Dolland/Dollander/Board New.png

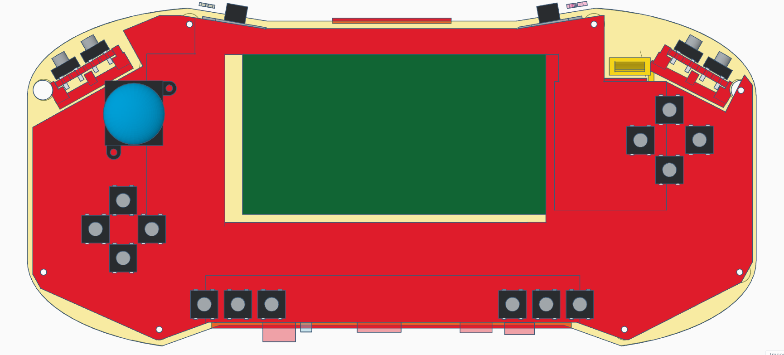
Board New.png
