Dolland/Dollander/board.png

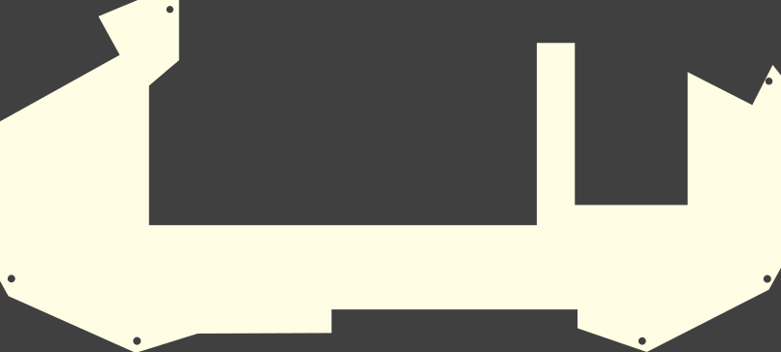
board.png
