Dolland/Dollander/pi-audio-raspi3-audio-schematic-rethemed.jpg

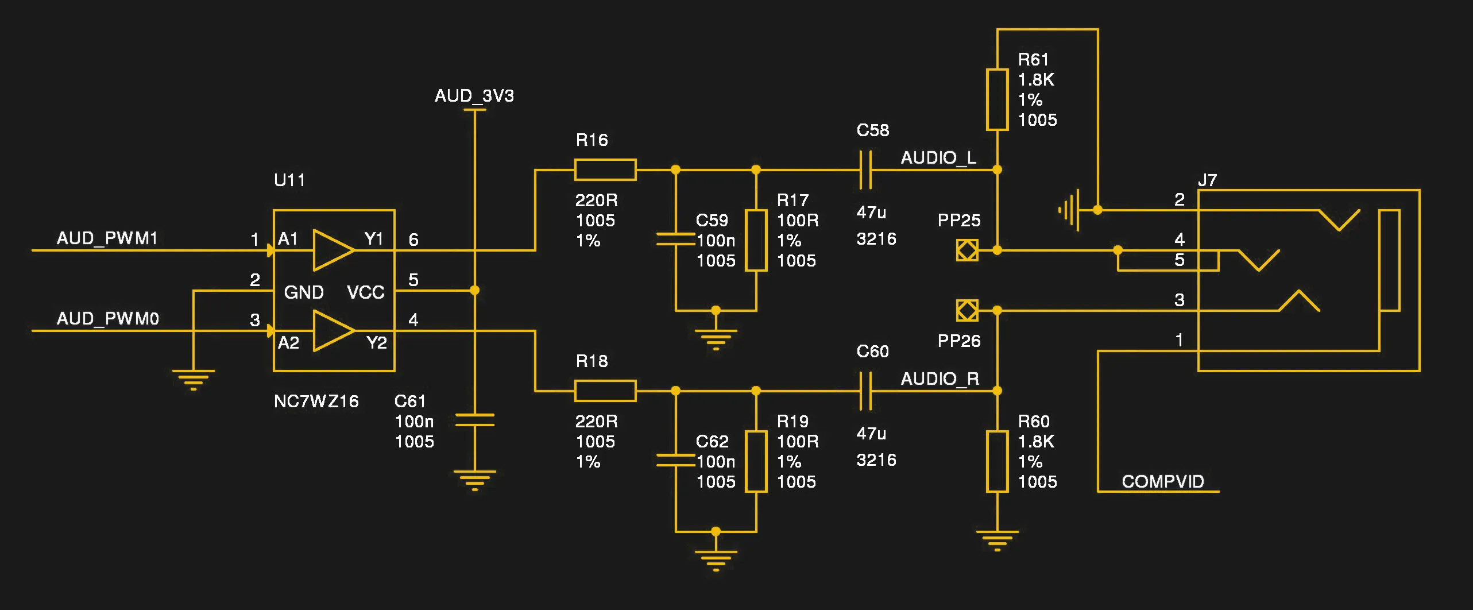
pi-audio-raspi3-audio-schematic-rethemed.jpg
