Dolland/Dollander/raspberry_pi_audiofilter.webp

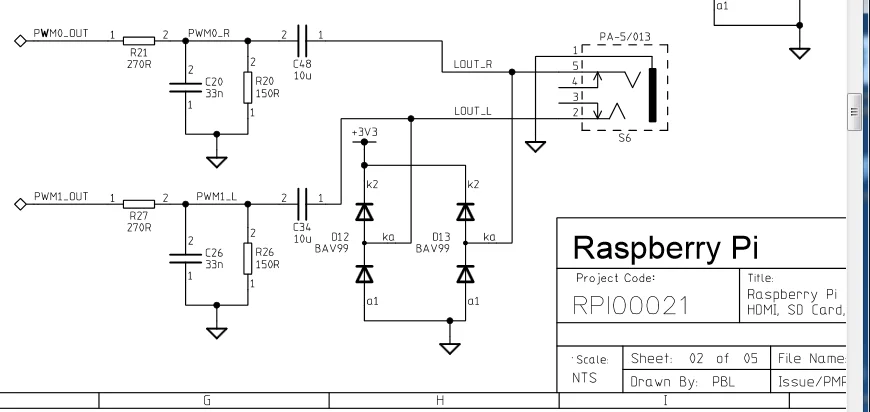
raspberry_pi_audiofilter.webp
