Dolland/Dollander/5inch-hdmi-lcd-sku10563_asm.stp

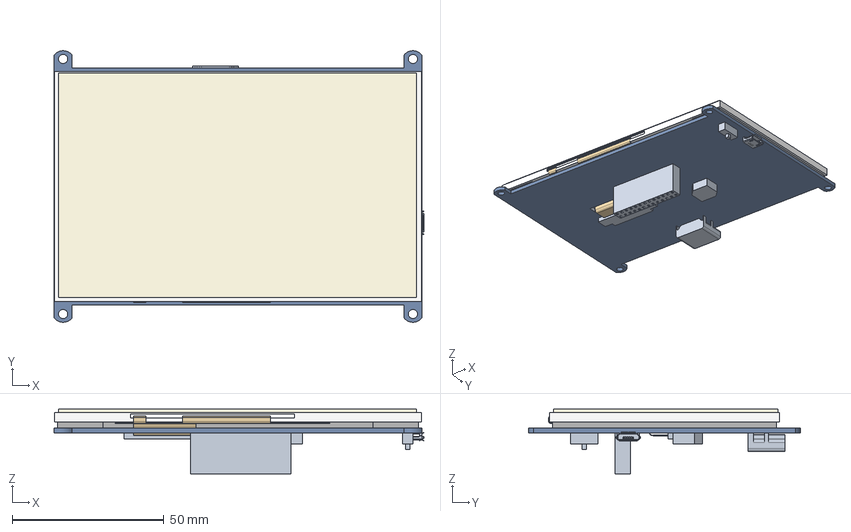
[picture p5: CAD file, 2024-05-19]
5inch-hdmi-lcd-sku10563_asm.stp
121.8 x 89.4 x 21.3 mm
5INCH-LCD-800X480
5INCH-EVA
5INCH-HDMI-LCD-PCB
5INCH-TP
