Dolland/Dollander/Board Console 2023.step

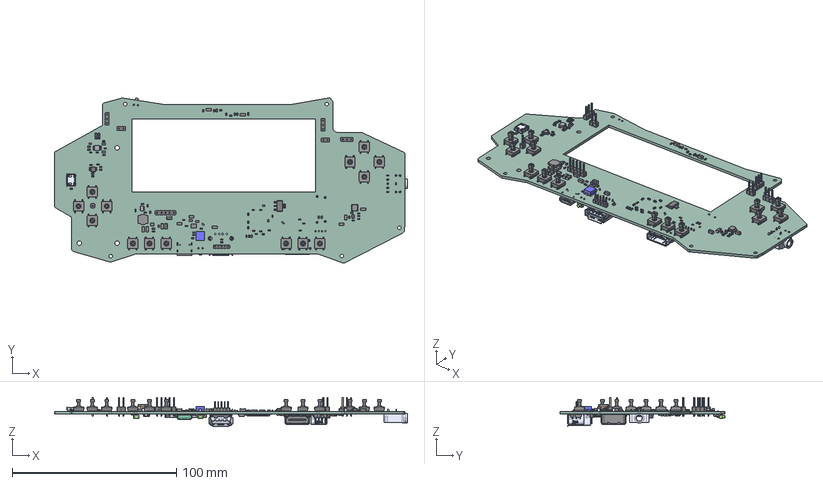
[picture p6: CAD file, 2024-05-20]
Board Console 2023.step
214.9 x 100.6 x 17.9 mm
L_Bourns-SRN4018
R_0603_1608Metric x 45
C_0603_1608Metric x 48
SW_SPST_Omron_B3FS-105xP x 14
PinHeader_1x02_P254mm_Vertical x 2
PinHeader_1x03_P254mm_Vertical x 3
L_1206_3216Metric x 4
PinHeader_1x05_P200mm_Vertical
TC33X-2-202E x 2
C_1206_3216Metric x 10
C_0805_2012Metric x 4
L_0805_2012Metric x 8
PinHeader_1x01_P254mm_Vertical
MP2720AGRH
PinHeader_1x05_P254mm_Vertical
L_Bourns_SRN6045TA
10118194-0001LF
TSSOP_10_3x3mm_P05mm
ASSEMBLY
SOT_223 x 3
D_SOD_123 x 2
R_Array_Convex_4x0603 x 7
RUA42
C-4-1734839-0
LED_D1.8mm_W1.8mm_H2.4mm_Horizontal_O1.27mm_Z1.6mm x 2
10029449-111RLF x 2
CUI_DEVICES_SJ1-3525N
TSOT_23
PZP100
PinHeader_1x04_P200mm_Vertical
M-UE27-AC54-100-REVT1
_X2_4E006B21_X0_MOLDING_-261340
Fillet003_fd_sp
EVQ-P7A01P
Board Console 2023_PCB
