Dolland/Dollander/board.stl

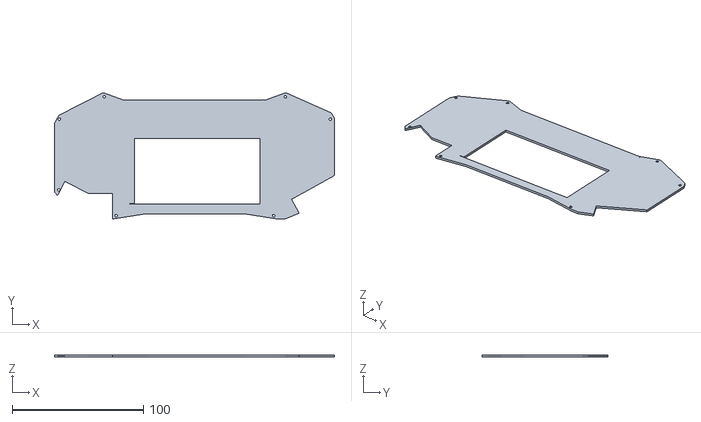
[picture p7: CAD file, 2024-05-19]
board.stl
213.3 x 96.0 x 1.60
