Dolland/Dollander/Board Console 2023.kicad_pcb

## KiCad design Board Console 2023.kicad_pcb (2024-07-20)

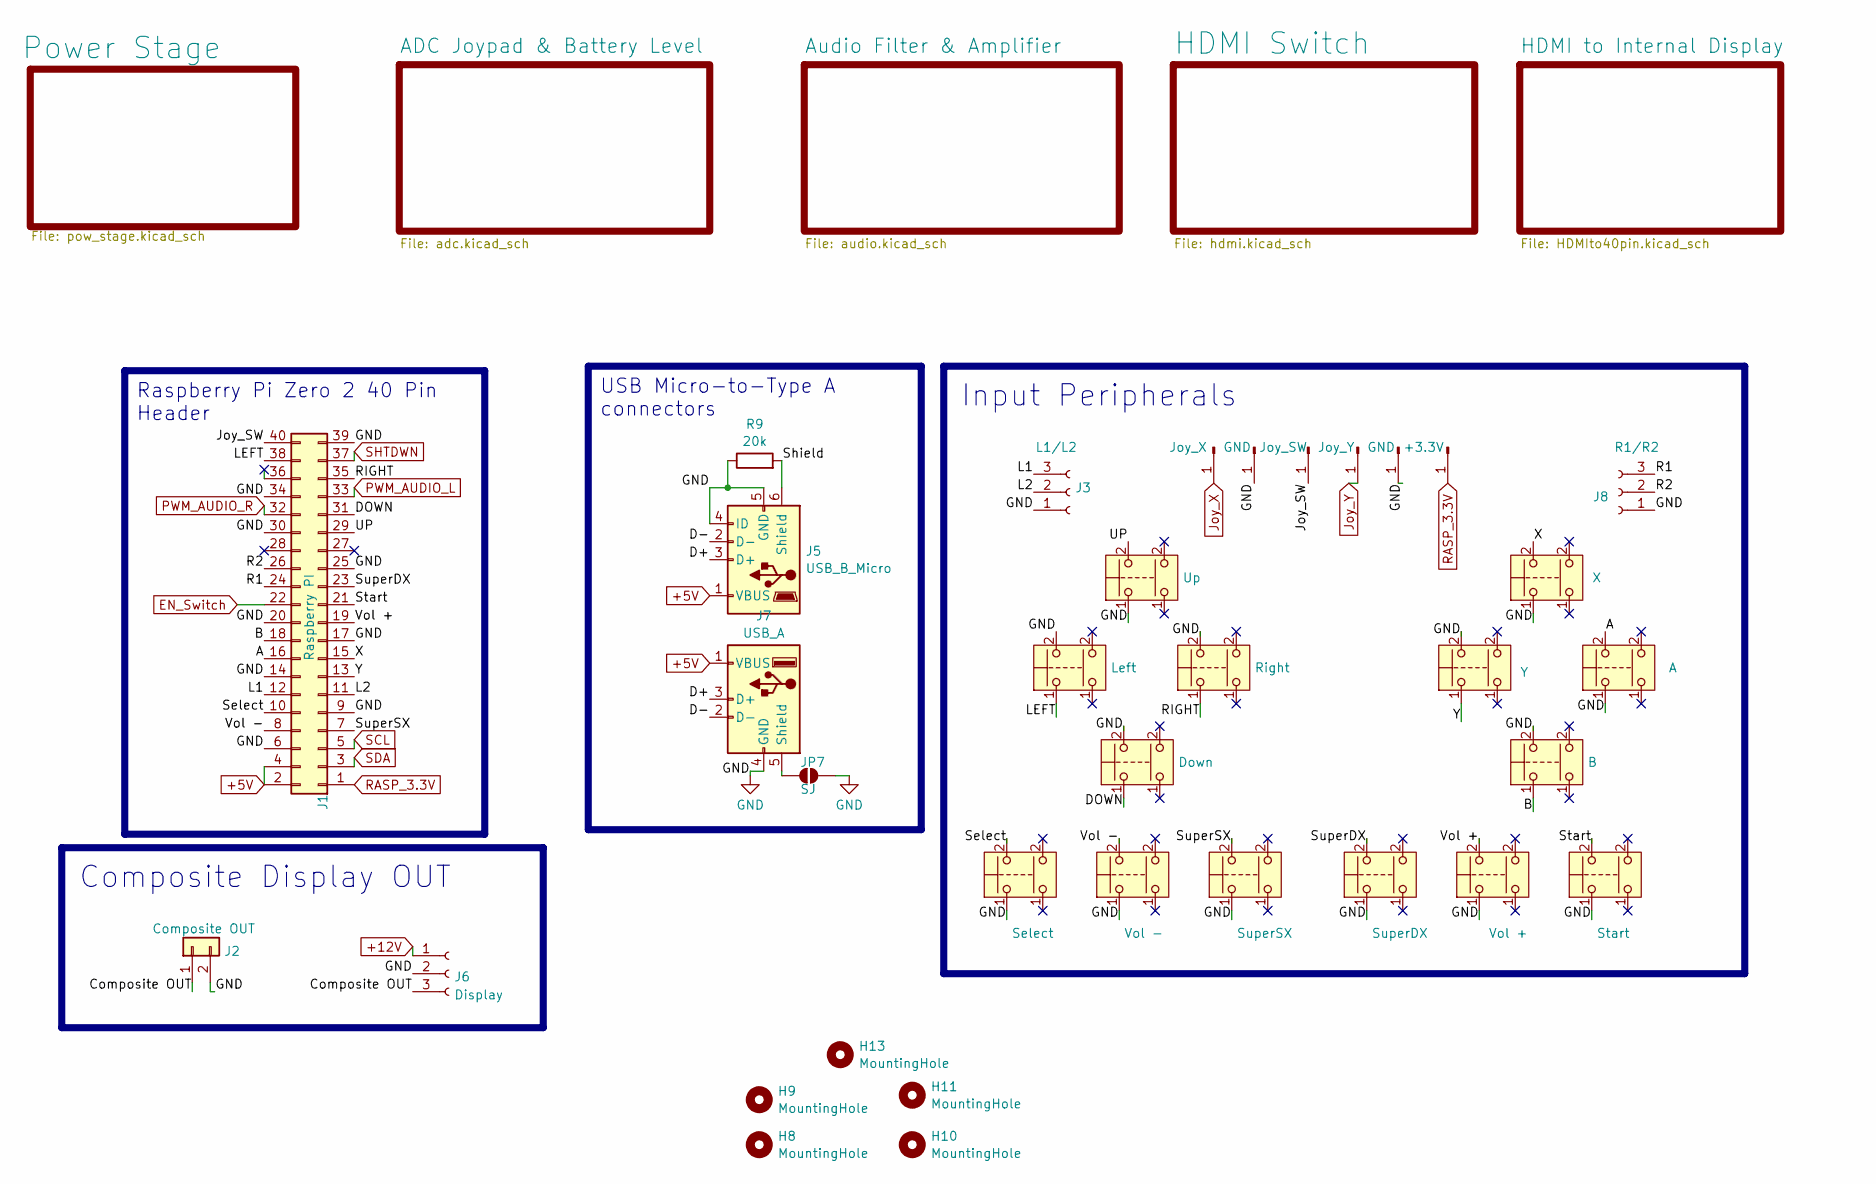
[picture p8: schematic Board Console 2023.kicad_sch, Console]

Parts:
H1: Joy_X; TestPoint_Pad_0.8x2.8
H2, H5: GND; TestPoint_Pad_0.8x2.8
H3: Joy_SW; TestPoint_Pad_0.8x2.8
H4: Joy_Y; TestPoint_Pad_0.8x2.8
H6: +3.3V; TestPoint_Pad_0.8x2.8
H8, H9, H10, H11, H13: MountingHole; MountingHole_2.2mm_M2
J1: Raspberry PI; Raspberry_Pi_Zero_Socketed_THT_FaceUp_MountingHoles
J2: Composite OUT; PinHeader_1x02_P2.00mm_Vertical
J3: L1/L2; PinHeader_1x03_P2.54mm_Vertical
J5: USB_B_Micro; USB_Micro-B_Amphenol_10118194_Horizontal
J6: Display; PinHeader_1x03_P2.54mm_Vertical
J7: USB_A; AMPHENOL_UE27AC5410H
J8: R1/R2; PinHeader_1x03_P2.54mm_Vertical
JP7: SJ; SolderJumper-2_P1.3mm_Open_Pad1.0x1.5mm
R9: 20k; R_0603_1608Metric_Pad0.98x0.95mm_HandSolder
SW3: Vol -; SW_Push_1P1T_NO_6x6mm_H9.5mm
SW4: SuperSX; SW_Push_1P1T_NO_6x6mm_H9.5mm
SW5: Select; SW_Push_1P1T_NO_6x6mm_H9.5mm
SW6: Vol +; SW_Push_1P1T_NO_6x6mm_H9.5mm
SW7: Start; SW_Push_1P1T_NO_6x6mm_H9.5mm
SW8: B; SW_Push_1P1T_NO_6x6mm_H9.5mm
SW9: Y; SW_Push_1P1T_NO_6x6mm_H9.5mm
SW10: A; SW_Push_1P1T_NO_6x6mm_H9.5mm
SW11: X; SW_Push_1P1T_NO_6x6mm_H9.5mm
SW12: Down; SW_Push_1P1T_NO_6x6mm_H9.5mm
SW13: Left; SW_Push_1P1T_NO_6x6mm_H9.5mm
SW14: Up; SW_Push_1P1T_NO_6x6mm_H9.5mm
SW15: Right; SW_Push_1P1T_NO_6x6mm_H9.5mm
SW17: SuperDX; SW_Push_1P1T_NO_6x6mm_H9.5mm

Connections:
+5V: J1.2, J1.4, J5.1 (VBUS), J7.1 (VBUS); also elsewhere on the board
+12V: J6.1; also elsewhere on the board
/A: J1.16, SW10.2
/B: J1.18, SW8.1
/Composite OUT: J2.1, J6.3
/D+: J5.3 (D+), J7.3 (D+)
/D-: J5.2 (D-), J7.2 (D-)
/DOWN: J1.31, SW12.1
/Joy_SW: H3.1, J1.40
/L1: J1.12, J3.3
/L2: J1.11, J3.2
/LEFT: J1.38, SW13.1
/R1: J1.24, J8.3
/R2: J1.26, J8.2
/RIGHT: J1.35, SW15.1
/Select: J1.10, SW5.2
/Shield: J5.6 (Shield), R9.2
/Start: J1.21, SW7.2
/SuperDX: J1.23, SW17.2
/SuperSX: J1.7, SW4.2
/UP: J1.29, SW14.2
/Vol +: J1.19, SW6.2
/Vol -: J1.8, SW3.2
/X: J1.15, SW11.2
/Y: J1.13, SW9.1
EN_Switch: J1.22; also elsewhere on the board
GND: H2.1, H5.1, J1.6, J1.9, J1.14, J1.17, J1.20, J1.25, J1.30, J1.34, J1.39, J2.2, J3.1, J5.4 (ID), J5.5 (GND), J6.2, J7.4 (GND), J8.1, JP7.1 (A), R9.1, SW3.1, SW4.1, SW5.1, SW6.1, SW7.1, SW8.2, SW9.2, SW10.1, SW11.1, SW12.2, SW13.2, SW14.1, SW15.2, SW17.1; also elsewhere on the board
Joy_X: H1.1; also elsewhere on the board
Joy_Y: H4.1; also elsewhere on the board
unnamed: J7.5 (Shield), JP7.2 (B)
PWM_AUDIO_L: J1.33; also elsewhere on the board
PWM_AUDIO_R: J1.32; also elsewhere on the board
RASP_3.3V: H6.1, J1.1; also elsewhere on the board
SCL: J1.5; also elsewhere on the board
SDA: J1.3; also elsewhere on the board
SHTDWN: J1.37; also elsewhere on the board

Notes on the sheet:
Composite Display OUT
Raspberry Pi Zero 2 40 Pin Header
USB Micro-to-Type A connectors
Input Peripherals

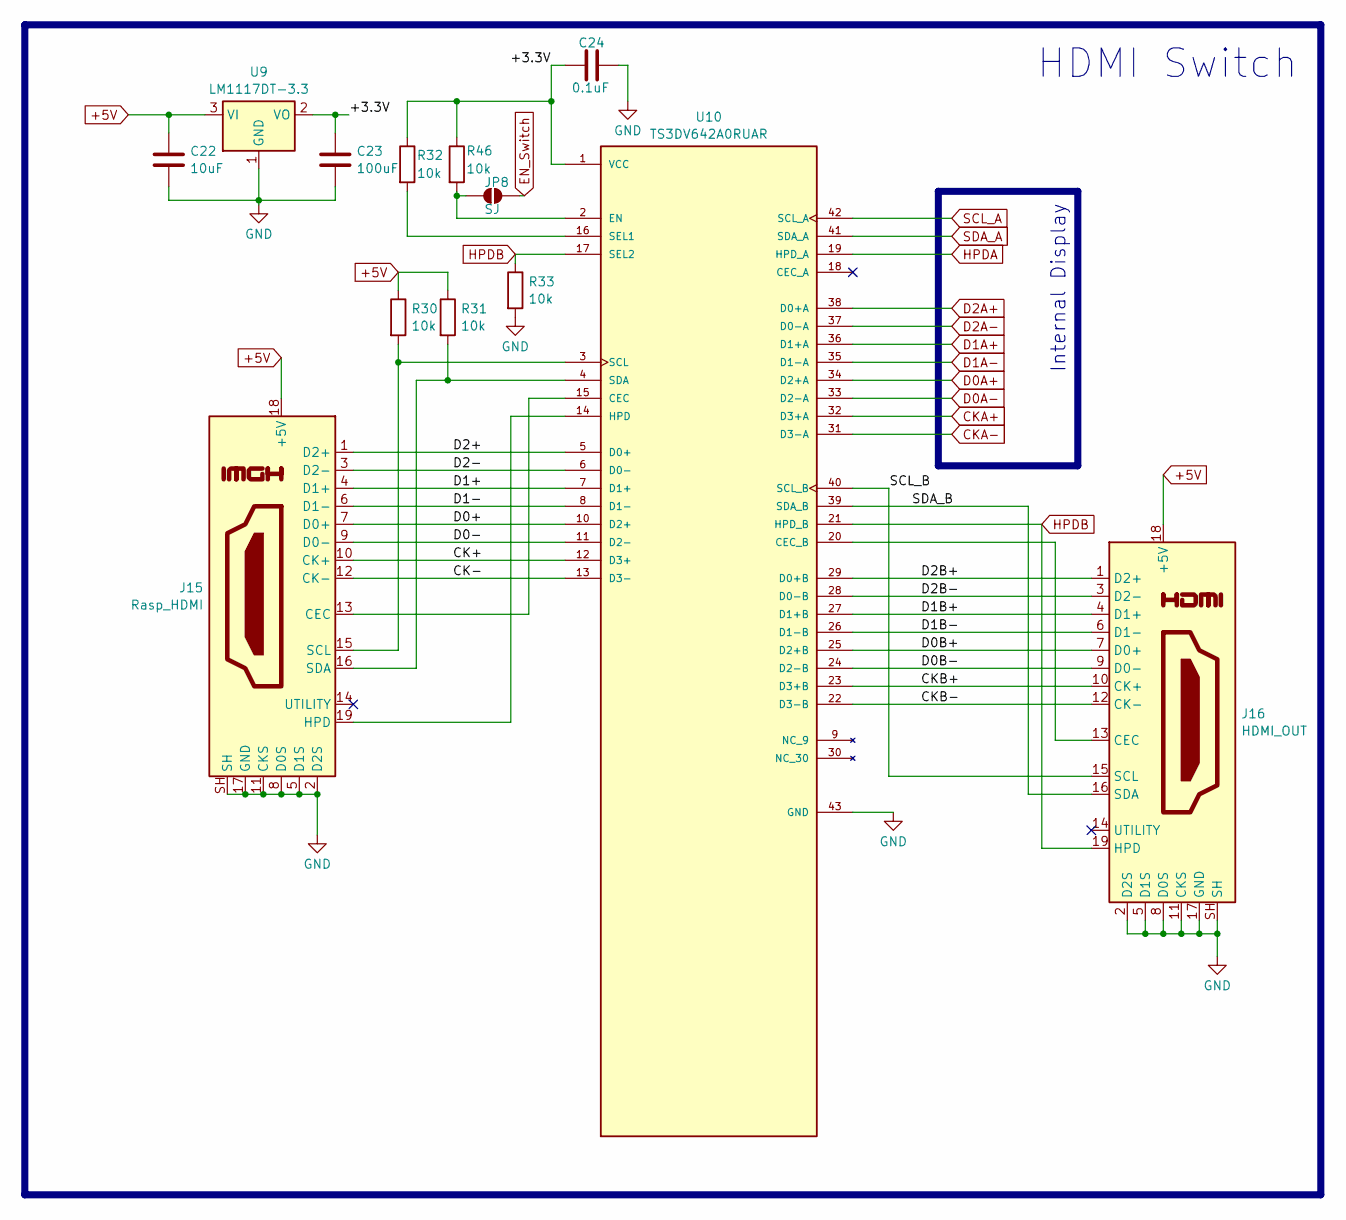
[picture p9: schematic hdmi.kicad_sch]

Parts:
C22: 10uF; C_0603_1608Metric_Pad1.08x0.95mm_HandSolder
C23: 100uF; C_1206_3216Metric_Pad1.33x1.80mm_HandSolder
C24: 0.1uF; C_0603_1608Metric_Pad1.08x0.95mm_HandSolder
J15: Rasp_HDMI; HDMI_A_Amphenol_10029449-x01xLF_Horizontal
J16: HDMI_OUT; HDMI_A_Amphenol_10029449-x01xLF_Horizontal
JP8: SJ; SolderJumper-2_P1.3mm_Open_Pad1.0x1.5mm
R30, R31, R32, R33, R46: 10k; R_0603_1608Metric_Pad0.98x0.95mm_HandSolder
U9: LM1117DT-3.3; SOT-223-3_TabPin2
U10: TS3DV642A0RUAR; QFN50P900X350X80-43N; PARTREV 4219139/A 03/2020

Connections:
+5V: C22.1, J15.18 (+5V), J16.18 (+5V), R30.1, R31.1, U9.3 (VI); also elsewhere on the board
/HDMI Switch/+3.3V: C23.1, C24.1, R32.1, R46.1, U9.2 (VO), U10.1 (VCC)
/HDMI Switch/CK+: J15.10 (CK+), U10.12 (D3+)
/HDMI Switch/CK-: J15.12 (CK-), U10.13 (D3-)
/HDMI Switch/CKB+: J16.10 (CK+), U10.23 (D3+B)
/HDMI Switch/CKB-: J16.12 (CK-), U10.22 (D3-B)
/HDMI Switch/D0+: J15.7 (D0+), U10.10 (D2+)
/HDMI Switch/D0-: J15.9 (D0-), U10.11 (D2-)
/HDMI Switch/D0B+: J16.7 (D0+), U10.25 (D2+B)
/HDMI Switch/D0B-: J16.9 (D0-), U10.24 (D2-B)
/HDMI Switch/D1+: J15.4 (D1+), U10.7 (D1+)
/HDMI Switch/D1-: J15.6 (D1-), U10.8 (D1-)
/HDMI Switch/D1B+: J16.4 (D1+), U10.27 (D1+B)
/HDMI Switch/D1B-: J16.6 (D1-), U10.26 (D1-B)
/HDMI Switch/D2+: J15.1 (D2+), U10.5 (D0+)
/HDMI Switch/D2-: J15.3 (D2-), U10.6 (D0-)
/HDMI Switch/D2B+: J16.1 (D2+), U10.29 (D0+B)
/HDMI Switch/D2B-: J16.3 (D2-), U10.28 (D0-B)
/HDMI Switch/SCL_B: J16.15 (SCL), U10.40 (SCL_B)
/HDMI Switch/SDA_B: J16.16 (SDA), U10.39 (SDA_B)
CKA+: U10.32 (D3+A); also elsewhere on the board
CKA-: U10.31 (D3-A); also elsewhere on the board
D0A+: U10.34 (D2+A); also elsewhere on the board
D0A-: U10.33 (D2-A); also elsewhere on the board
D1A+: U10.36 (D1+A); also elsewhere on the board
D1A-: U10.35 (D1-A); also elsewhere on the board
D2A+: U10.38 (D0+A); also elsewhere on the board
D2A-: U10.37 (D0-A); also elsewhere on the board
EN_Switch: JP8.1 (A); also elsewhere on the board
GND: C22.2, C23.2, C24.2, J15.2 (D2S), J15.5 (D1S), J15.8 (D0S), J15.11 (CKS), J15.17 (GND), J15.SH, J16.2 (D2S), J16.5 (D1S), J16.8 (D0S), J16.11 (CKS), J16.17 (GND), J16.SH, R33.2, U9.1 (GND), U10.43 (GND); also elsewhere on the board
HPDA: U10.19 (HPD_A); also elsewhere on the board
HPDB: J16.19 (HPD), R33.1, U10.17 (SEL2), U10.21 (HPD_B)
unnamed: J15.13 (CEC), U10.15 (CEC)
unnamed: J15.19 (HPD), U10.14 (HPD)
unnamed: J15.15 (SCL), R30.2, U10.3 (SCL)
unnamed: J15.16 (SDA), R31.2, U10.4 (SDA)
unnamed: J16.13 (CEC), U10.20 (CEC_B)
unnamed: JP8.2 (B), R46.2, U10.2 (EN)
unnamed: R32.2, U10.16 (SEL1)
SCL_A: U10.42 (SCL_A); also elsewhere on the board
SDA_A: U10.41 (SDA_A); also elsewhere on the board

Notes on the sheet:
Internal Display
HDMI Switch

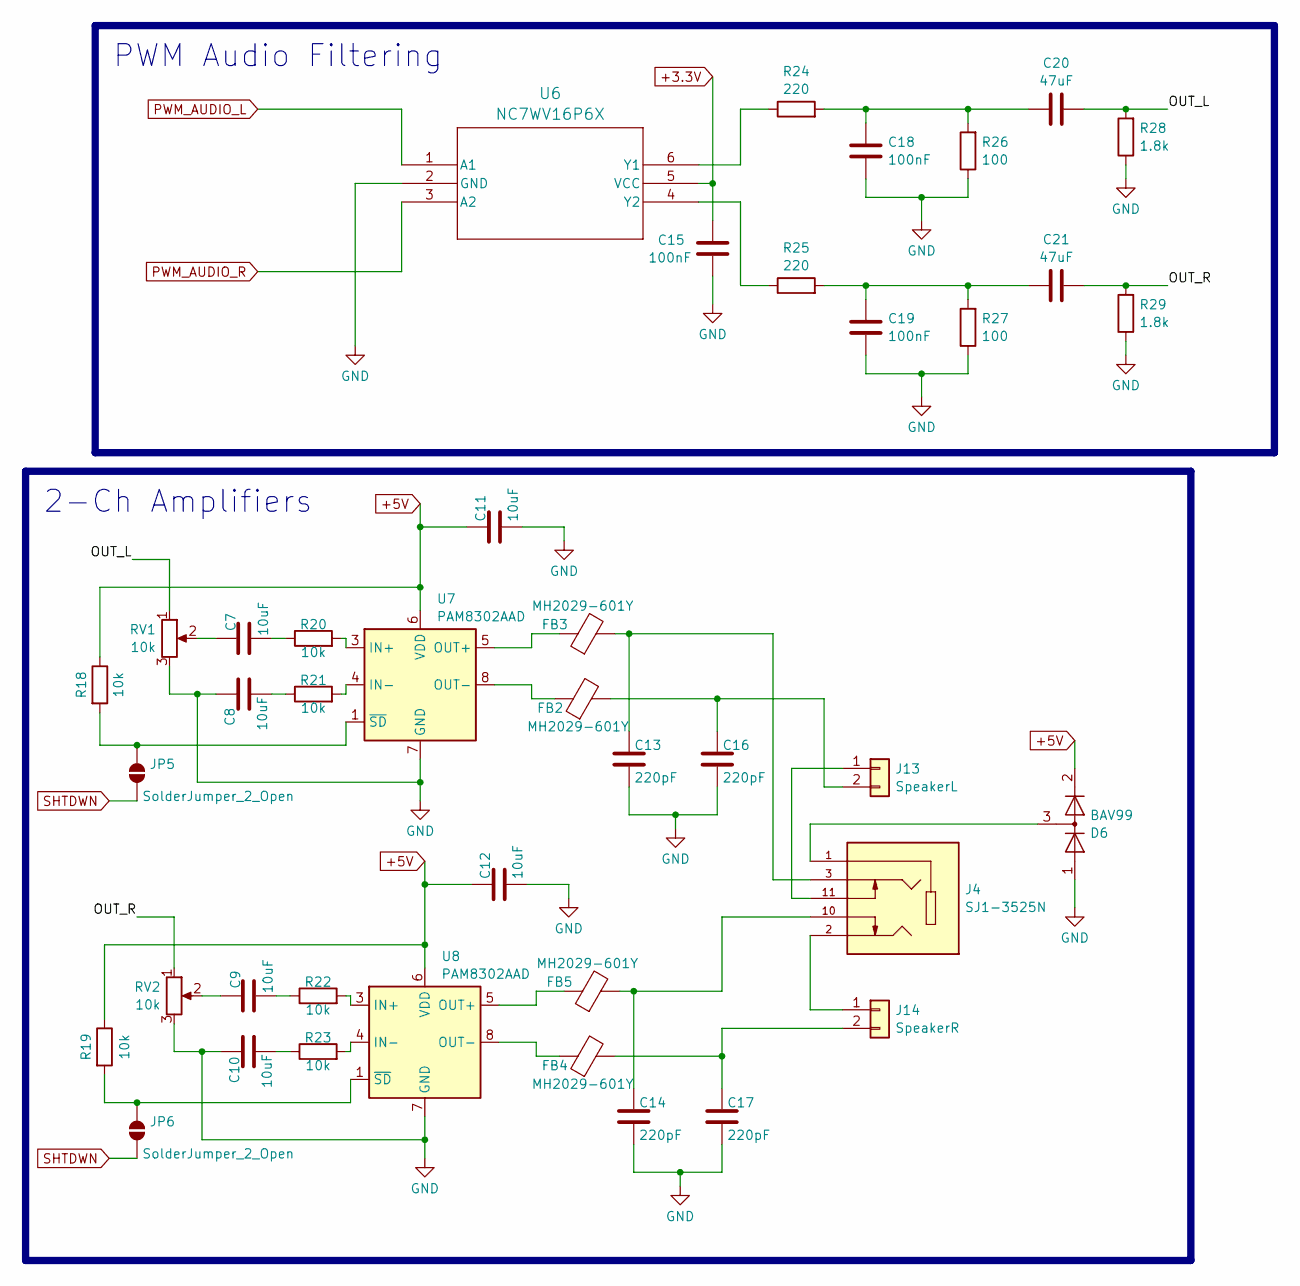
[picture p10: schematic audio.kicad_sch]

Parts:
C7, C8, C9, C10, C11, C12: 10uF; C_0603_1608Metric_Pad1.08x0.95mm_HandSolder
C13, C14, C16, C17: 220pF; C_0603_1608Metric_Pad1.08x0.95mm_HandSolder
C15, C18, C19: 100nF; C_0603_1608Metric_Pad1.08x0.95mm_HandSolder
C20, C21: 47uF; C_1206_3216Metric_Pad1.33x1.80mm_HandSolder
D6: BAV99; SOT-23
FB2, FB3, FB4, FB5: MH2029-601Y; L_0805_2012Metric_Pad1.05x1.20mm_HandSolder
J4: SJ1-3525N; CUI_SJ1-3525N; PARTREV 1.05
J13: SpeakerL; PinHeader_1x02_P2.54mm_Vertical
J14: SpeakerR; PinHeader_1x02_P2.54mm_Vertical
JP5, JP6: SolderJumper_2_Open; SolderJumper-2_P1.3mm_Open_Pad1.0x1.5mm
R18, R19, R20, R21, R22, R23: 10k; R_0603_1608Metric_Pad0.98x0.95mm_HandSolder
R24, R25: 220; R_0603_1608Metric_Pad0.98x0.95mm_HandSolder
R26, R27: 100; R_0603_1608Metric_Pad0.98x0.95mm_HandSolder
R28, R29: 1.8k; R_0603_1608Metric_Pad0.98x0.95mm_HandSolder
RV1, RV2: 10k; Potentiometer_Bourns_TC33X_Vertical
U6: NC7WV16P6X; SC70-6_2P2X1P35_ONS
U7, U8: PAM8302AAD; PAM8302AASCR_DIO

Connections:
+3.3V: C15.2, U6.5 (VCC); also elsewhere on the board
+5V: C11.1, C12.1, D6.2 (A), R18.1, R19.1, U7.6 (VDD), U8.6 (VDD); also elsewhere on the board
/Audio Filter & Amplifier/OUT_L: C20.2, R28.2, RV1.1
/Audio Filter & Amplifier/OUT_R: C21.2, R29.2, RV2.1
GND: C8.1, C10.1, C11.2, C12.2, C13.2, C14.2, C15.1, C16.2, C17.2, C18.2, C19.2, D6.1 (K), R26.1, R27.1, R28.1, R29.1, RV1.3, RV2.3, U6.2 (GND), U7.7 (GND), U8.7 (GND); also elsewhere on the board
unnamed: C7.1, RV1.2
unnamed: C7.2, R20.1
unnamed: C8.2, R21.1
unnamed: C9.1, RV2.2
unnamed: C9.2, R22.1
unnamed: C10.2, R23.1
unnamed: C13.1, FB3.2, J4.3
unnamed: C14.1, FB5.2, J4.10
unnamed: C18.1, C20.1, R24.2, R26.2
unnamed: C19.1, C21.1, R25.2, R27.2
unnamed: D6.3 (K), J4.1
unnamed: J4.11, J13.1
unnamed: C16.1, FB2.2, J13.2
unnamed: J4.2, J14.1
unnamed: C17.1, FB4.2, J14.2
unnamed: JP5.2 (B), R18.2, U7.1 (~SD)
unnamed: JP6.2 (B), R19.2, U8.1 (~SD)
unnamed: R24.1, U6.6 (Y1)
unnamed: R25.1, U6.4 (Y2)
unnamed: R20.2, U7.3 (IN+)
unnamed: R21.2, U7.4 (IN-)
unnamed: FB3.1, U7.5 (OUT+)
unnamed: FB2.1, U7.8 (OUT-)
unnamed: R22.2, U8.3 (IN+)
unnamed: R23.2, U8.4 (IN-)
unnamed: FB5.1, U8.5 (OUT+)
unnamed: FB4.1, U8.8 (OUT-)
PWM_AUDIO_L: U6.1 (A1); also elsewhere on the board
PWM_AUDIO_R: U6.3 (A2); also elsewhere on the board
SHTDWN: JP5.1 (A), JP6.1 (A); also elsewhere on the board

Notes on the sheet:
PWM Audio Filtering
2-Ch Amplifiers

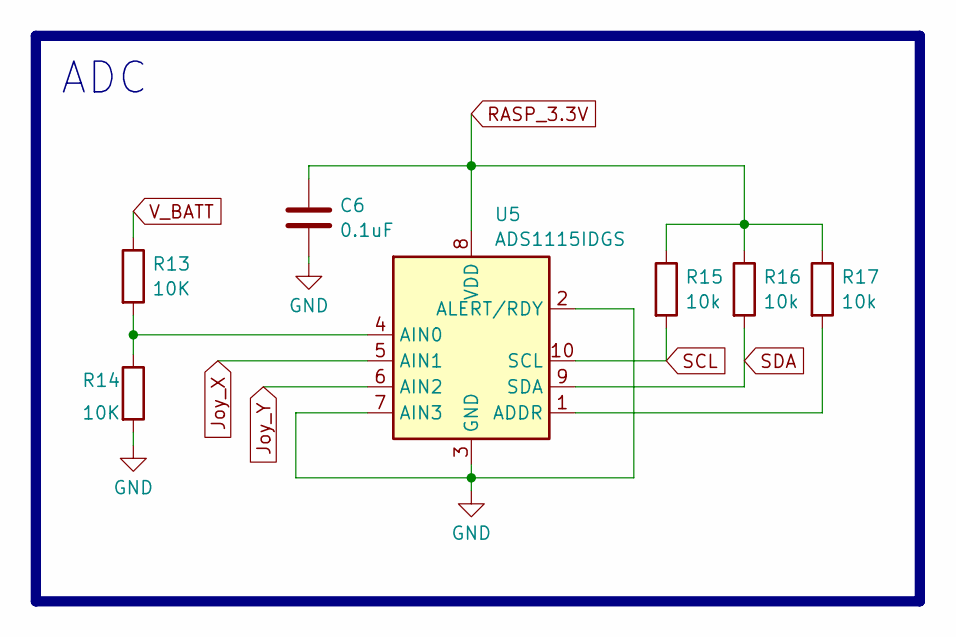
[picture p11: schematic adc.kicad_sch]

Parts:
C6: 0.1uF; C_0603_1608Metric_Pad1.08x0.95mm_HandSolder
R13, R14: 10K; R_0603_1608Metric_Pad0.98x0.95mm_HandSolder
R15, R16, R17: 10k; R_0603_1608Metric_Pad0.98x0.95mm_HandSolder
U5: ADS1115IDGS; TSSOP-10_3x3mm_P0.5mm

Connections:
GND: C6.2, R14.2, U5.2 (ALERT/RDY), U5.3 (GND), U5.7 (AIN3); also elsewhere on the board
Joy_X: U5.5 (AIN1); also elsewhere on the board
Joy_Y: U5.6 (AIN2); also elsewhere on the board
unnamed: R17.2, U5.1 (ADDR)
unnamed: R13.2, R14.1, U5.4 (AIN0)
RASP_3.3V: C6.1, R15.1, R16.1, R17.1, U5.8 (VDD); also elsewhere on the board
SCL: R15.2, U5.10 (SCL); also elsewhere on the board
SDA: R16.2, U5.9 (SDA); also elsewhere on the board
V_BATT: R13.1; also elsewhere on the board

Notes on the sheet:
ADC

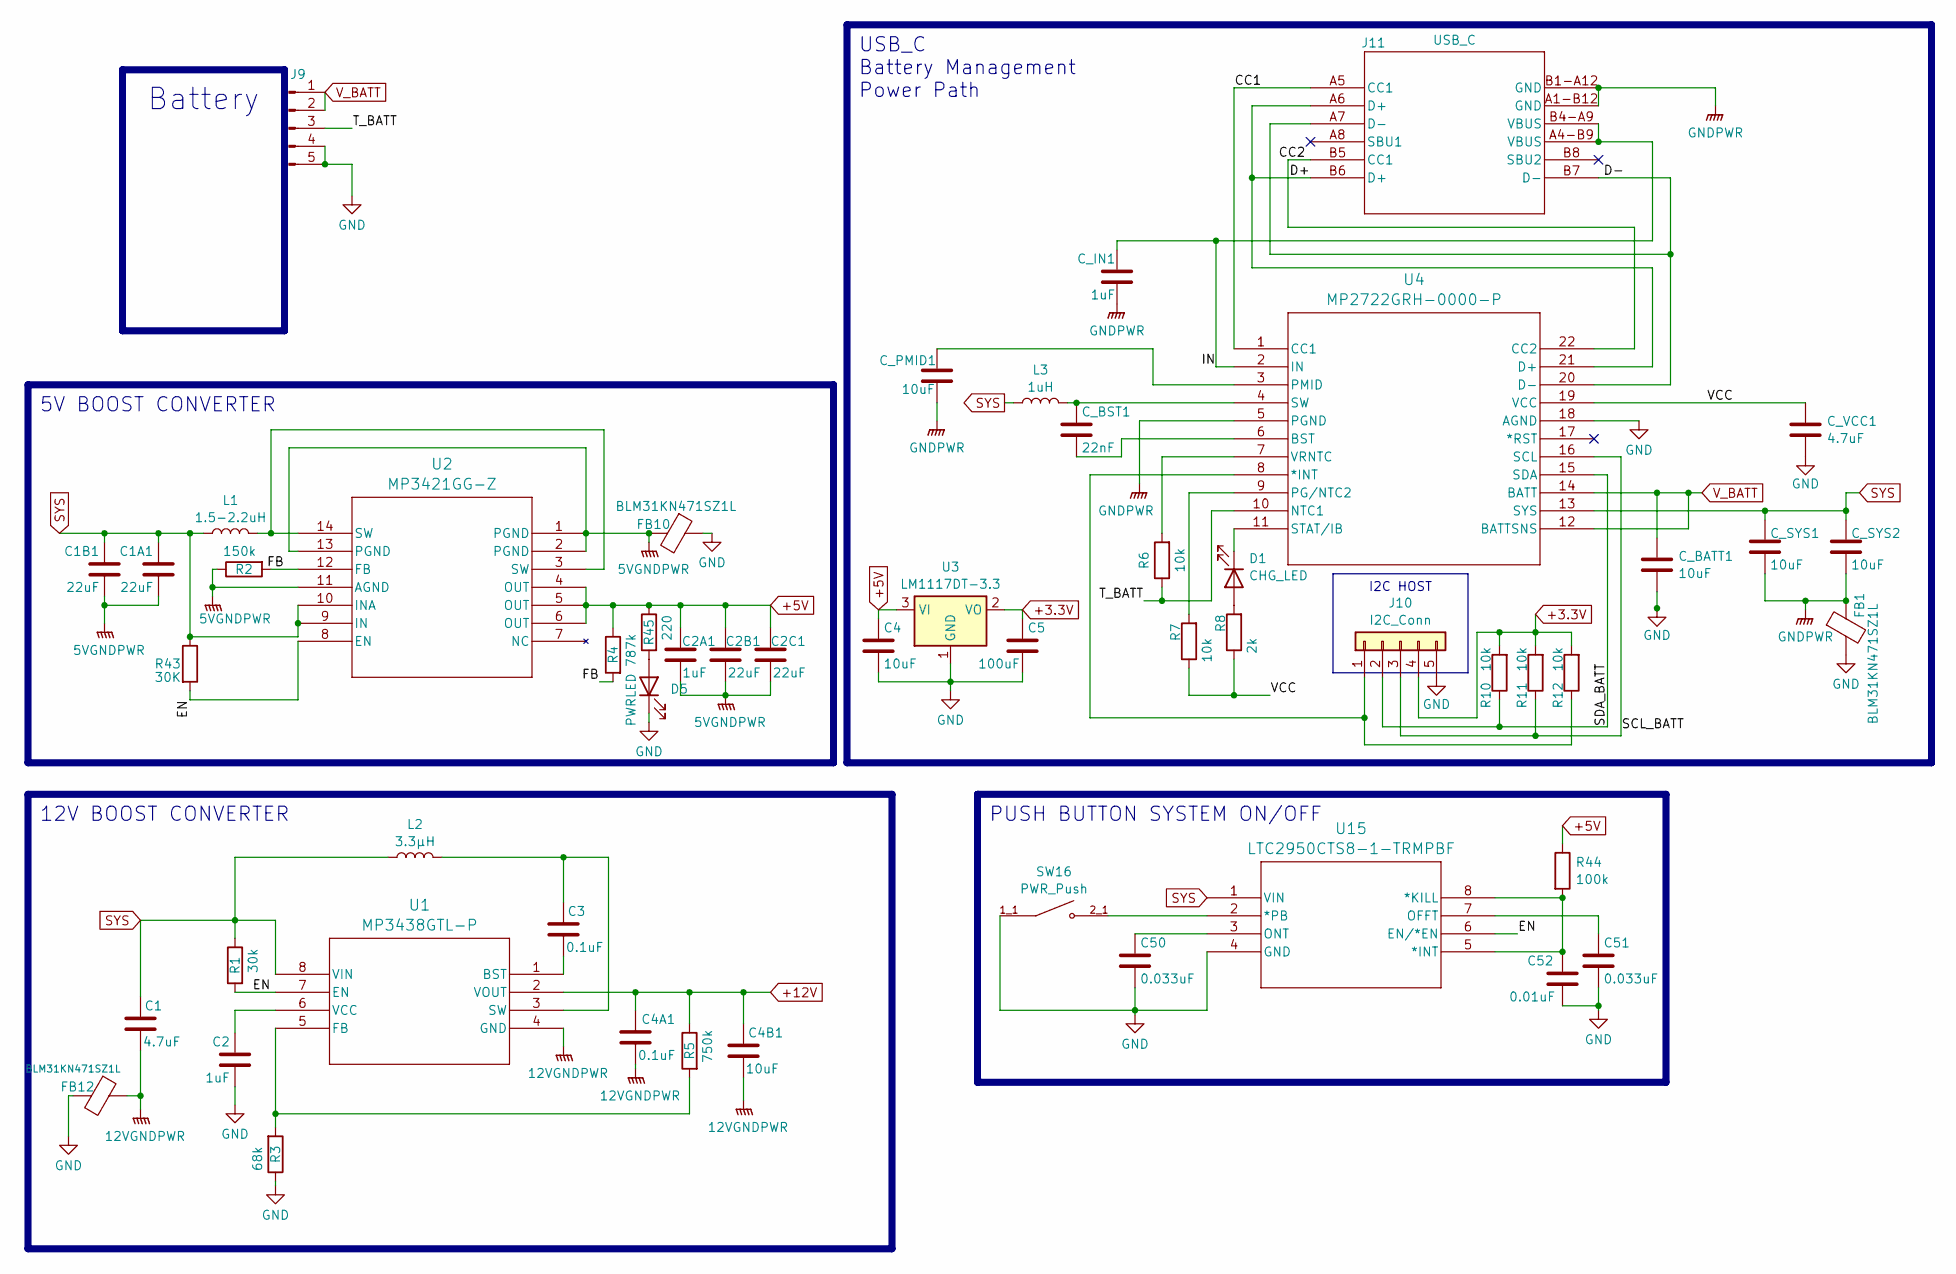
[picture p12: schematic pow_stage.kicad_sch]

Parts:
C1: 4.7uF; C_1206_3216Metric_Pad1.33x1.80mm_HandSolder
C1A1, C1B1, C2B1, C2C1: 22uF; C_1206_3216Metric_Pad1.33x1.80mm_HandSolder
C2, C2A1: 1uF; C_0603_1608Metric_Pad1.08x0.95mm_HandSolder
C3, C4A1: 0.1uF; C_0603_1608Metric_Pad1.08x0.95mm_HandSolder
C4: 10uF; C_0603_1608Metric_Pad1.08x0.95mm_HandSolder
C4B1: 10uF; C_1206_3216Metric_Pad1.33x1.80mm_HandSolder
C5: 100uF; C_1206_3216Metric_Pad1.33x1.80mm_HandSolder
C50, C51: 0.033uF; C_0603_1608Metric_Pad1.08x0.95mm_HandSolder
C52: 0.01uF; C_0603_1608Metric_Pad1.08x0.95mm_HandSolder
C_BATT1: 10uF; C_0805_2012Metric_Pad1.18x1.45mm_HandSolder
C_BST1: 22nF; C_0603_1608Metric_Pad1.08x0.95mm_HandSolder
C_IN1: 1uF; C_0603_1608Metric_Pad1.08x0.95mm_HandSolder
C_PMID1: 10uF; C_0805_2012Metric_Pad1.18x1.45mm_HandSolder
C_SYS1, C_SYS2: 10uF; C_0805_2012Metric_Pad1.18x1.45mm_HandSolder
C_VCC1: 4.7uF; C_0603_1608Metric_Pad1.08x0.95mm_HandSolder
D1: CHG_LED; LED_D1.8mm_W1.8mm_H2.4mm_Horizontal_O1.27mm_Z1.6mm
D5: PWRLED; LED_D1.8mm_W1.8mm_H2.4mm_Horizontal_O1.27mm_Z1.6mm
FB1, FB10, FB12: BLM31KN471SZ1L; L_1206_3216Metric_Pad1.22x1.90mm_HandSolder
J9: V_BATT; PinHeader_1x05_P2.54mm_Vertical
J10: I2C_Conn; PinHeader_1x05_P2.00mm_Vertical
J11: USB_C; 12402012E212A_AMP
L1: 1.5-2.2uH; L_Bourns_SRN6045TA
L2: 3.3µH; L_Vishay_IFSC-1515AH_4x4x1.8mm
L3: 1uH; L_Bourns_SRP5030T
R1: 30k; R_0603_1608Metric_Pad0.98x0.95mm_HandSolder
R2: 150k; R_0603_1608Metric_Pad0.98x0.95mm_HandSolder
R3: 68k; R_0603_1608Metric_Pad0.98x0.95mm_HandSolder
R4: 787k; R_0603_1608Metric_Pad0.98x0.95mm_HandSolder
R5: 750k; R_0603_1608Metric_Pad0.98x0.95mm_HandSolder
R6, R7, R10, R11, R12: 10k; R_0603_1608Metric_Pad0.98x0.95mm_HandSolder
R8: 2k; R_0603_1608Metric_Pad0.98x0.95mm_HandSolder
R43: 30K; R_0603_1608Metric_Pad0.98x0.95mm_HandSolder
R44: 100k; R_0603_1608Metric_Pad0.98x0.95mm_HandSolder
R45: 220; R_0603_1608Metric_Pad0.98x0.95mm_HandSolder
SW16: PWR_Push; SW_EVQ-P7A01P; PARTREV 2022.4
U1: MP3438GTL-P; SOT583_MP3438_MNP
U2: MP3421GG-Z; QFN-14_MP3421_MNP
U3: LM1117DT-3.3; SOT-223-3_TabPin2
U4: MP2722GRH-0000-P; QFN-22_MP2722_MNP
U15: LTC2950CTS8-1-TRMPBF; TSOT-23_TS8_LIT

Connections:
5VGNDPWR: C1A1.2, C1B1.2, C2A1.2, C2B1.2, C2C1.2, FB10.2, R2.1, U2.1 (PGND), U2.2 (PGND), U2.11 (AGND), U2.13 (PGND)
12VGNDPWR: C1.2, C4A1.2, C4B1.2, FB12.1, U1.4 (GND)
+3.3V: C5.1, J10.4, R10.2, R11.2, R12.2, U3.2 (VO); also elsewhere on the board
+5V: C2A1.1, C2B1.1, C2C1.1, C4.1, R4.1, R44.1, R45.1, U2.4 (OUT), U2.5 (OUT), U2.6 (OUT), U3.3 (VI); also elsewhere on the board
+12V: C4A1.1, C4B1.1, R5.1, U1.2 (VOUT); also elsewhere on the board
/Power Stage/CC1: J11.A5 (CC1), U4.1 (CC1)
/Power Stage/CC2: J11.B5 (CC1), U4.22 (CC2)
/Power Stage/D+: J11.A6 (D+), J11.B6 (D+), U4.21 (D+)
/Power Stage/D-: J11.A7 (D-), J11.B7 (D-), U4.20 (D-)
/Power Stage/EN: R1.2, R43.2, U1.7 (EN), U2.8 (EN), U15.6 (EN/*EN)
/Power Stage/FB: R2.2, R4.2, U2.12 (FB)
/Power Stage/IN: C_IN1.1, J11.A4-B9 (VBUS), J11.B4-A9 (VBUS), U4.2 (IN)
/Power Stage/SCL_BATT: J10.3, R11.1, U4.16 (SCL)
/Power Stage/SDA_BATT: J10.2, R10.1, U4.15 (SDA)
/Power Stage/T_BATT: J9.3, R6.1, U4.10 (NTC1)
/Power Stage/VCC: C_VCC1.1, R7.1, R8.1, U4.19 (VCC)
GND: C2.2, C4.2, C5.2, C50.2, C51.2, C52.2, C_BATT1.2, C_VCC1.2, D5.1 (K), FB1.2, FB10.1, FB12.2, J9.4, J9.5, J10.5, R3.1, SW16.1_1, U3.1 (GND), U4.18 (AGND), U15.4 (GND); also elsewhere on the board
GNDPWR: C_IN1.2, C_PMID1.2, C_SYS1.2, C_SYS2.2, FB1.1, J11.A1-B12 (GND), J11.B1-A12 (GND), U4.5 (PGND)
unnamed: D1.2 (A), R8.2
unnamed: D1.1 (K), U4.11 (STAT/IB)
unnamed: D5.2 (A), R45.2
unnamed: J10.1, R12.1, U4.8 (*INT)
unnamed: L1.1, U2.3 (SW), U2.14 (SW)
unnamed: C3.2, U1.1 (BST)
unnamed: R3.2, R5.2, U1.5 (FB)
unnamed: C3.1, L2.1, U1.3 (SW)
unnamed: C2.1, U1.6 (VCC)
unnamed: C_BST1.2, U4.6 (BST)
unnamed: R7.2, U4.9 (PG/NTC2)
unnamed: C_PMID1.1, U4.3 (PMID)
unnamed: C_BST1.1, L3.2, U4.4 (SW)
unnamed: R6.2, U4.7 (VRNTC)
unnamed: C52.1, R44.2, U15.5 (*INT), U15.8 (*KILL)
unnamed: SW16.2_1, U15.2 (*PB)
unnamed: C51.1, U15.7 (OFFT)
unnamed: C50.1, U15.3 (ONT)
SYS: C1.1, C1A1.1, C1B1.1, C_SYS1.1, C_SYS2.1, L1.2, L2.2, L3.1, R1.1, R43.1, U1.8 (VIN), U2.9 (IN), U2.10 (INA), U4.13 (SYS), U15.1 (VIN)
V_BATT: C_BATT1.1, J9.1, J9.2, U4.12 (BATTSNS), U4.14 (BATT); also elsewhere on the board

Notes on the sheet:
PUSH BUTTON SYSTEM ON/OFF
5V BOOST CONVERTER
I2C HOST
12V BOOST CONVERTER
Battery
USB_C Battery Management Power Path

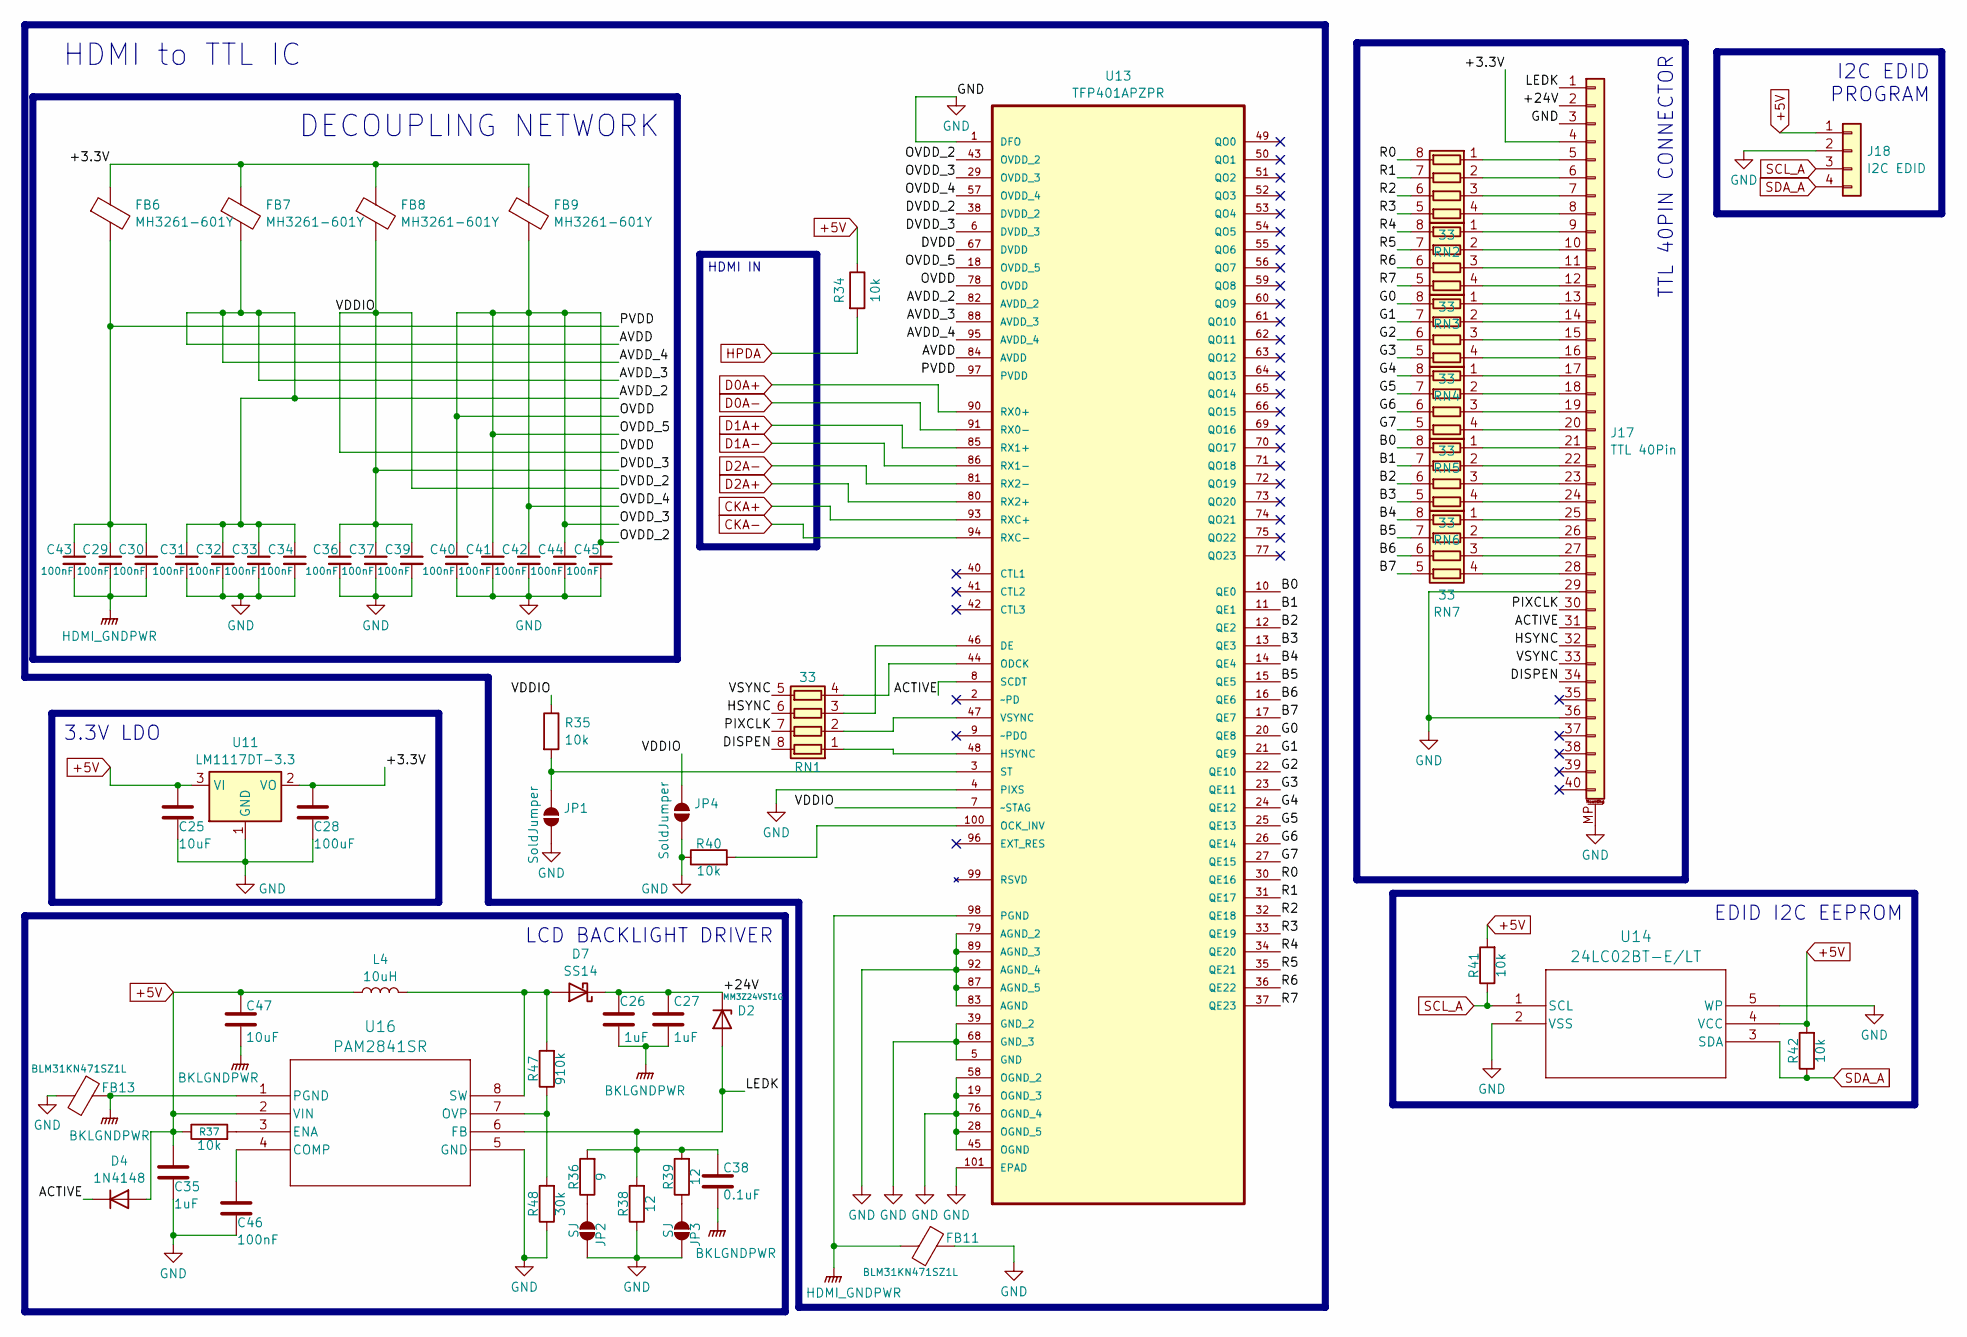
[picture p13: schematic HDMIto40pin.kicad_sch]

Parts:
C25, C47: 10uF; C_0603_1608Metric_Pad1.08x0.95mm_HandSolder
C26, C27, C35: 1uF; C_0603_1608Metric_Pad1.08x0.95mm_HandSolder
C28: 100uF; C_1206_3216Metric_Pad1.33x1.80mm_HandSolder
C29, C30, C31, C32, C33, C34, C36, C37, C39, C40, C41, C42, C43, C44, C45, C46: 100nF; C_0603_1608Metric_Pad1.08x0.95mm_HandSolder
C38: 0.1uF; C_0603_1608Metric_Pad1.08x0.95mm_HandSolder
D2: MM3Z24VST1G; D_SOD-123
D4: 1N4148; D_SOD-123
D7: SS14; D_SMA
FB6, FB7, FB8, FB9: MH3261-601Y; L_0805_2012Metric_Pad1.05x1.20mm_HandSolder
FB11, FB13: BLM31KN471SZ1L; L_1206_3216Metric_Pad1.22x1.90mm_HandSolder
J17: TTL 40Pin; Omron_XF2M-4015-1A_1x40-1MP_P0.5mm_Horizontal
J18: I2C EDID; PinHeader_1x04_P2.00mm_Vertical
JP1, JP4: SoldJumper; SolderJumper-2_P1.3mm_Open_Pad1.0x1.5mm
JP2, JP3: SJ; SolderJumper-2_P1.3mm_Open_Pad1.0x1.5mm
L4: 10uH; L_TDK_SLF6025
R34, R35, R37, R40, R41, R42: 10k; R_0603_1608Metric_Pad0.98x0.95mm_HandSolder
R36: 9; R_0603_1608Metric_Pad0.98x0.95mm_HandSolder
R38, R39: 12; R_0603_1608Metric_Pad0.98x0.95mm_HandSolder
R47: 910k; R_0603_1608Metric_Pad0.98x0.95mm_HandSolder
R48: 30k; R_0603_1608Metric_Pad0.98x0.95mm_HandSolder
RN1, RN2, RN3, RN4, RN5, RN6, RN7: 33; EXB28V_PAN
U11: LM1117DT-3.3; SOT-223-3_TabPin2
U13: TFP401APZPR; QFP50P1600X1600X120-101N; MPN TFP401APZPR
U14: 24LC02BT-E/LT; SC70-5_MC_MCH
U16: PAM2841SR; PAM2841

Connections:
+5V: C25.1, C35.1, C47.1, D4.2 (A), J18.1, L4.1, R34.1, R37.1, R41.2, R42.2, U11.3 (VI), U14.4 (VCC), U16.2 (VIN); also elsewhere on the board
/HDMI to Internal Display/+3.3V: C28.1, FB6.1, FB7.1, FB8.1, FB9.1, J17.4, U11.2 (VO)
/HDMI to Internal Display/+24V: C26.1, C27.1, D2.1 (K), D7.1 (K), J17.2
/HDMI to Internal Display/ACTIVE: D4.1 (K), J17.31, U13.8 (SCDT)
/HDMI to Internal Display/AVDD: C31.1, C32.1, C33.1, C34.1, FB7.2, U13.82 (AVDD_2), U13.84 (AVDD), U13.88 (AVDD_3), U13.95 (AVDD_4)
/HDMI to Internal Display/B0: RN6.8 (R1.2), U13.10 (QE0)
/HDMI to Internal Display/B1: RN6.7 (R2.2), U13.11 (QE1)
/HDMI to Internal Display/B2: RN6.6 (R3.2), U13.12 (QE2)
/HDMI to Internal Display/B3: RN6.5 (R4.2), U13.13 (QE3)
/HDMI to Internal Display/B4: RN7.8 (R1.2), U13.14 (QE4)
/HDMI to Internal Display/B5: RN7.7 (R2.2), U13.15 (QE5)
/HDMI to Internal Display/B6: RN7.6 (R3.2), U13.16 (QE6)
/HDMI to Internal Display/B7: RN7.5 (R4.2), U13.17 (QE7)
/HDMI to Internal Display/DISPEN: J17.34, RN1.8 (R1.2)
/HDMI to Internal Display/DVDD: C36.1, C37.1, C39.1, FB8.2, JP4.2 (B), R35.1, U13.6 (DVDD_3), U13.7 (~STAG), U13.38 (DVDD_2), U13.67 (DVDD)
/HDMI to Internal Display/G0: RN4.8 (R1.2), U13.20 (QE8)
/HDMI to Internal Display/G1: RN4.7 (R2.2), U13.21 (QE9)
/HDMI to Internal Display/G2: RN4.6 (R3.2), U13.22 (QE10)
/HDMI to Internal Display/G3: RN4.5 (R4.2), U13.23 (QE11)
/HDMI to Internal Display/G4: RN5.8 (R1.2), U13.24 (QE12)
/HDMI to Internal Display/G5: RN5.7 (R2.2), U13.25 (QE13)
/HDMI to Internal Display/G6: RN5.6 (R3.2), U13.26 (QE14)
/HDMI to Internal Display/G7: RN5.5 (R4.2), U13.27 (QE15)
/HDMI to Internal Display/HSYNC: J17.32, RN1.6 (R3.2)
/HDMI to Internal Display/LEDK: C38.1, D2.2 (A), J17.1, R36.2, R38.2, R39.2, U16.6 (FB)
/HDMI to Internal Display/OVDD: C40.1, C41.1, C42.1, C44.1, C45.1, FB9.2, U13.18 (OVDD_5), U13.29 (OVDD_3), U13.43 (OVDD_2), U13.57 (OVDD_4), U13.78 (OVDD)
/HDMI to Internal Display/PIXCLK: J17.30, RN1.7 (R2.2)
/HDMI to Internal Display/PVDD: C29.1, C30.1, C43.1, FB6.2, U13.97 (PVDD)
/HDMI to Internal Display/R0: RN2.8 (R1.2), U13.30 (QE16)
/HDMI to Internal Display/R1: RN2.7 (R2.2), U13.31 (QE17)
/HDMI to Internal Display/R2: RN2.6 (R3.2), U13.32 (QE18)
/HDMI to Internal Display/R3: RN2.5 (R4.2), U13.33 (QE19)
/HDMI to Internal Display/R4: RN3.8 (R1.2), U13.34 (QE20)
/HDMI to Internal Display/R5: RN3.7 (R2.2), U13.35 (QE21)
/HDMI to Internal Display/R6: RN3.6 (R3.2), U13.36 (QE22)
/HDMI to Internal Display/R7: RN3.5 (R4.2), U13.37 (QE23)
/HDMI to Internal Display/VSYNC: J17.33, RN1.5 (R4.2)
BKLGNDPWR: C26.2, C27.2, C38.2, C47.2, FB13.1, U16.1 (PGND)
CKA+: U13.93 (RXC+); also elsewhere on the board
CKA-: U13.94 (RXC-); also elsewhere on the board
D0A+: U13.90 (RX0+); also elsewhere on the board
D0A-: U13.91 (RX0-); also elsewhere on the board
D1A+: U13.85 (RX1+); also elsewhere on the board
D1A-: U13.86 (RX1-); also elsewhere on the board
D2A+: U13.80 (RX2+); also elsewhere on the board
D2A-: U13.81 (RX2-); also elsewhere on the board
GND: C25.2, C28.2, C31.2, C32.2, C33.2, C34.2, C35.2, C36.2, C37.2, C39.2, C40.2, C41.2, C42.2, C44.2, C45.2, C46.2, FB11.1, FB13.2, J17.3, J17.29, J17.36, J17.MP (MountPin), J18.2, JP1.1 (A), JP2.1 (A), JP3.1 (A), JP4.1 (A), R38.1, R40.1, R48.1, U11.1 (GND), U13.1 (DFO), U13.4 (PIXS), U13.5 (GND), U13.19 (OGND_3), U13.28 (OGND_5), U13.39 (GND_2), U13.45 (OGND), U13.58 (OGND_2), U13.68 (GND_3), U13.76 (OGND_4), U13.79 (AGND_2), U13.83 (AGND), U13.87 (AGND_5), U13.89 (AGND_3), U13.92 (AGND_4), U13.101 (EPAD), U14.2 (VSS), U14.5 (WP), U16.5 (GND); also elsewhere on the board
HDMI_GNDPWR: C29.2, C30.2, C43.2, FB11.2, U13.98 (PGND)
HPDA: R34.2; also elsewhere on the board
unnamed: D7.2 (A), L4.2, R47.2, U16.8 (SW)
unnamed: J17.5, RN2.1 (R1.1)
unnamed: J17.6, RN2.2 (R2.1)
unnamed: J17.7, RN2.3 (R3.1)
unnamed: J17.8, RN2.4 (R4.1)
unnamed: J17.9, RN3.1 (R1.1)
unnamed: J17.10, RN3.2 (R2.1)
unnamed: J17.11, RN3.3 (R3.1)
unnamed: J17.12, RN3.4 (R4.1)
unnamed: J17.13, RN4.1 (R1.1)
unnamed: J17.14, RN4.2 (R2.1)
unnamed: J17.15, RN4.3 (R3.1)
unnamed: J17.16, RN4.4 (R4.1)
unnamed: J17.17, RN5.1 (R1.1)
unnamed: J17.18, RN5.2 (R2.1)
unnamed: J17.19, RN5.3 (R3.1)
unnamed: J17.20, RN5.4 (R4.1)
unnamed: J17.21, RN6.1 (R1.1)
unnamed: J17.22, RN6.2 (R2.1)
unnamed: J17.23, RN6.3 (R3.1)
unnamed: J17.24, RN6.4 (R4.1)
unnamed: J17.25, RN7.1 (R1.1)
unnamed: J17.26, RN7.2 (R2.1)
unnamed: J17.27, RN7.3 (R3.1)
unnamed: J17.28, RN7.4 (R4.1)
unnamed: JP1.2 (B), R35.2, U13.3 (ST)
unnamed: JP2.2 (B), R36.1
unnamed: JP3.2 (B), R39.1
unnamed: RN1.1 (R1.1), U13.48 (HSYNC)
unnamed: RN1.2 (R2.1), U13.47 (VSYNC)
unnamed: RN1.3 (R3.1), U13.46 (DE)
unnamed: RN1.4 (R4.1), U13.44 (ODCK)
unnamed: R40.2, U13.100 (OCK_INV)
unnamed: C46.1, U16.4 (COMP)
unnamed: R37.2, U16.3 (ENA)
unnamed: R47.1, R48.2, U16.7 (OVP)
SCL_A: J18.3, R41.1, U14.1 (SCL); also elsewhere on the board
SDA_A: J18.4, R42.1, U14.3 (SDA); also elsewhere on the board

Notes on the sheet:
LCD BACKLIGHT DRIVER
3.3V LDO
DECOUPLING NETWORK
HDMI IN
EDID I2C EEPROM
I2C EDID PROGRAM
TTL 40PIN CONNECTOR
HDMI to TTL IC
