Dolland/Dollander/Board Console 2023.kicad_pcb

## KiCad design Board Console 2023.kicad_pcb (continued)

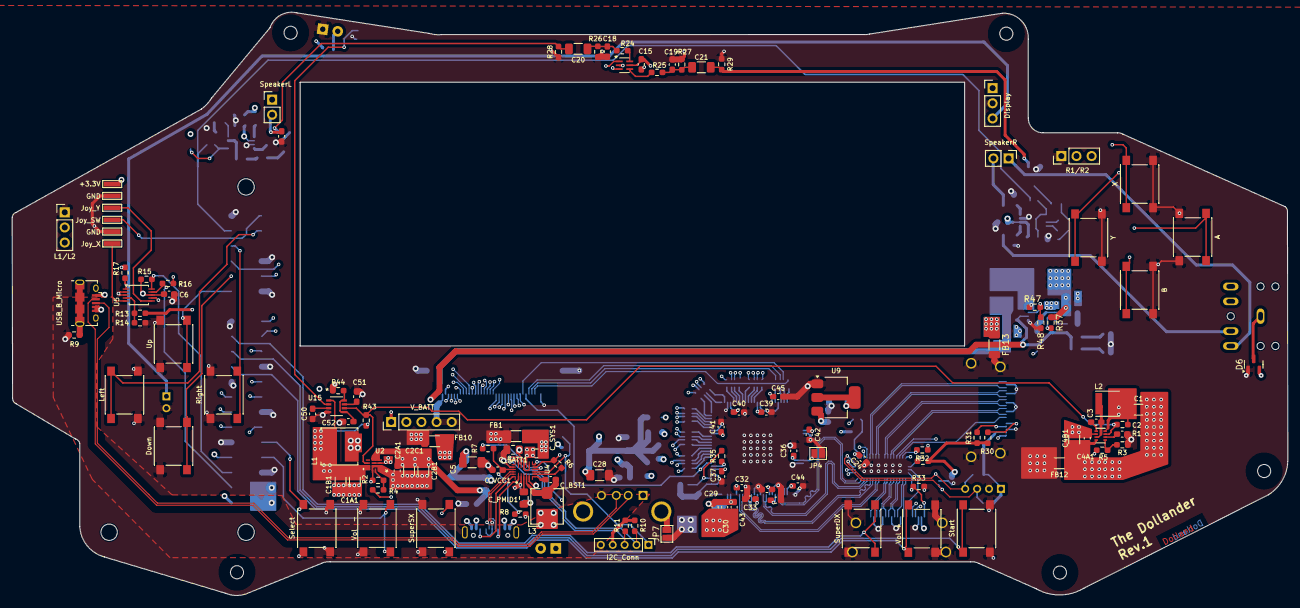
[picture p14: board Board Console 2023.kicad_pcb from above]

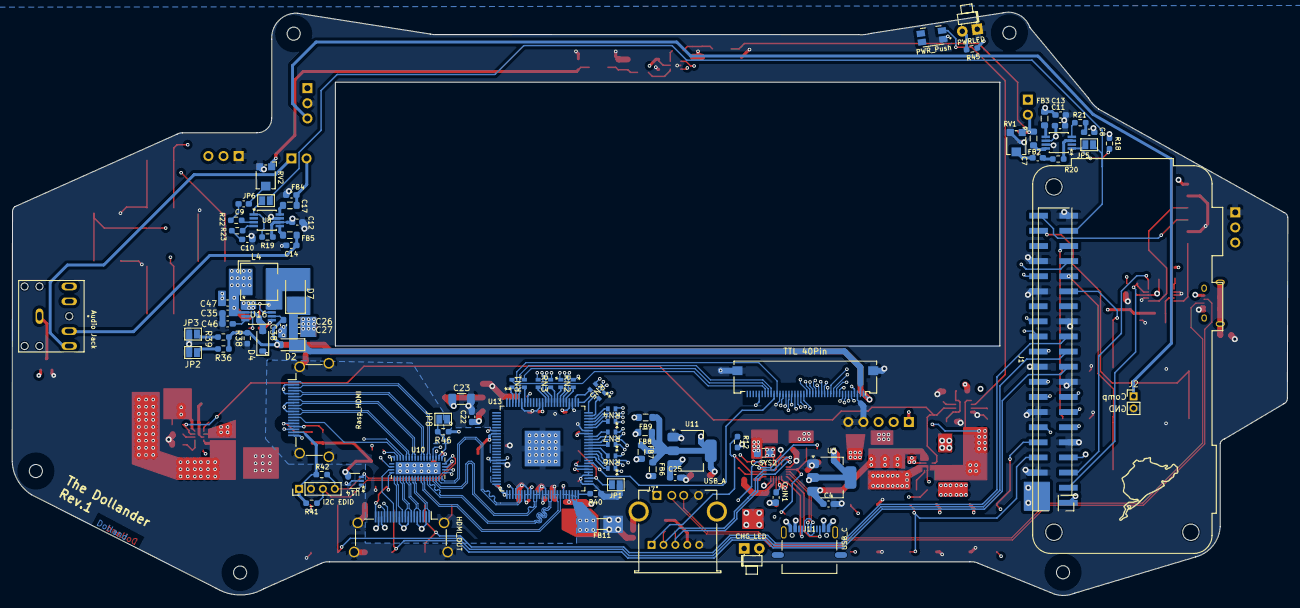
[picture p15: board Board Console 2023.kicad_pcb from below]

Board: 6 copper layers, 214.2 x 98.0 mm, 210 parts (84 on the bottom side), 214 nets.
