Dolland/Dollander/(commit log)

2024-05-23 fix hdmi traces and push button kill pin supply
2024-05-28 update layout pcb & zip tesi
2024-05-31 edit posizioni porte e di alcune piste
2024-06-01 aggiunto pin enable switch per schermo composito
